bradfordembedded/i2cu/i2cu.sch

## KiCad design i2cu.sch (2015-09-01)

Schematic: i2cu.sch

Parts:
C1: 4.7N
C2, C3, C9, C11, C12, C13: 1U
C4, C5, C6, C7, C8, C14, C15, C16, C17: 0.1U
C10: 0.01U
D1, D5, D6: DRTR5VOU2SR
D2, D3, D4: LED-GRN
FB1, FB2: MI0603L301R
FID1, FID3: FID-CIR
FID2: FID-SQUARE
HOLE1, HOLE2, HOLE3, HOLE4: HOLE-3.5MM
J1: USB-MICRO-B
J2: HEADER-6PIN-2ROW
R1: 1M
R2, R6, R10: 220
R3, R9: 825K
R4, R8: 220K
R5, R7, R11, R12, R13: 15K
TP1, TP2, TP3, TP4, TP5, TP6, TP7, TP8: TEST-PAD
U1: MCP6001
U2: MCP2221-QFN
U3: IFX21401MB
U4: FET-N
U5: FXMA2102L8X
U6: 74LVC1T45

Notes on the sheet:
DAC AND ADC TO USE 4.096 V REFERENCE INTERNALLY GENERATED
GAIN OF 1.266 4.096 V -> 5.188 V
ADC1_IN WILL BE 79% OF VOUT 5.191 V => 4.096 V
NOTE 1: ALL LEDS ARE GREEN 0603 WITH 35 mcd @ 20 mA 2.0 V DROP @ 20 mA
RUN SHLD AROUND EXTERIOR OF PCB FOR ESD PROTECTION
GPIO IS AN INPUT
