bradfordembedded/i2cu/(threads)

Thread 1 (2015-08-14):

Add output over-current protection

bradfa, 2015-08-14:
Cause we don't want to have a short fry the borad.  If the IFX LDO doesn't already do this by itself, add some discrete protection to hiccup.
Ideally the over current protection would just hiccup (fold back, then turn back on, fold back, turn back on, etc) so that you don't have to unplug/replug the device when you cause a short.

A sensible limit of 100 mA output would likely be fine.

bradfa, 2015-08-18:
IFX21401 has an output current limit typical of 85 mA (51-120 mA min-max).  So this should take care of things.

Closed 2015-08-18.

Thread 2 (2015-08-14):

Tie shield and ground together with cap/resistor combo

bradfa, 2015-08-14:
To ensure ESD gets routed up to the host and absorbed correctly, as recommended by pretty much everyone.

Closed 2015-08-18.
