bradfordembedded/i2cu/(commit log)

2015-08-10 Schematic: Capture USB connector to USB2221 nets
    Includes +5V power and TVS for additional protection.
    [i2cu.sch]
2015-08-10 Schematic: Add fiducials and mounting holes
    [i2cu.sch]
2015-08-10 Schematic: Update info block
    [i2cu.sch]
2015-08-10 Schematic: Capture I2C level shifter our side
    [i2cu.sch]
2015-08-11 Schematic: Switch out MCP2221 for QFN version
    It'll be smaller in the final layout. Uses a different pinout than the
    DIP/TSSOP/SOIC version, so pins moved slightly to fit some NCs.
    [i2cu.sch]
2015-08-11 Schematic: Move level shifter rightwards
    To make more space for GPX and UXx pins to break outwards without
    needing to use net names.
    [i2cu.sch]
2015-08-11 Schematic: Move all captured circuits down and left
    For easier to fit the LED, ADC, DAC, and header without using net names.
    [i2cu.sch]
2015-08-11 Schematic: Capture output 6 pin header
    [i2cu.sch]
2015-08-11 Schematic: Fixup level shifter output side
    Add decoupling cap and neaten.
    [i2cu.sch]
2015-08-11 Schematic: Add decoupling and ESD protection to output header
    [i2cu.sch]
2015-08-11 Schematic: Capture variable output voltage source
    [i2cu.sch]
2015-08-13 Schematic: Use net names for USB2221 GP0-3
    [i2cu.sch]
2015-08-13 Schematic: Capture voltage divider for ADC1_IN
    Required moving the op-amp and LDO to the left to make space.
    [i2cu.sch]
2015-08-13 Schematic: Add decoupling cap to USB2221 VDD pin
    [i2cu.sch]
2015-08-13 Schematic: Change caps on USB2221 VUSB to 0.3 uF total
    Data sheet says 0.22 to 0.47 uF is recommended. Since 0.1 uF caps are
    cheap (no placement fees at macrofab), just use 3 of them.
    [i2cu.sch]
2015-08-13 Schematic: Capture I2C_LED
    147 ohms with 2.0 V drop when supplied with 5.0 V will result in 20.4 mA
    and approximately 35 mcd light output.
    [i2cu.sch]
2015-08-14 Schematic: Switch LED current limit R to 220 ohm
    Single resistor
    [i2cu.sch]
2015-08-14 Schematic: Add green LEDs for power in & out
    [i2cu.sch]
2015-08-14 Schematic: Remove DAC_OUT net name, use wire
    Because I can!
    [i2cu.sch]
2015-08-14 Schematic: Use GPIO for OE of level shifter
    So we can shut ourselves off from the target, if desired.
    Factory default state for GP0 GPIO is output, high, but pull up to
    ensure if it's tristated that it turns on by default.
    [i2cu.sch]
2015-08-14 Schematic: Put DAC1_OUT label back in, more clear
    [i2cu.sch]
2015-08-14 Schematic: Mark UART lines as NC
    [i2cu.sch]
2015-08-18 Schematic: Tie SHLD and GND thru parallel R and C
    Closes #2
    [i2cu.sch]
2015-08-18 Schematic: Tie I2C level shifter OE high
    No control for th level shifter, it's always on.
    Want to use the GPIO as an input.
    [i2cu.sch]
2015-08-18 Schematic: Change GPIO to input from target
    With level shifter and ESD protection.
    [i2cu.sch]
2015-08-18 Schematic: Double-up 1U caps
    There's 3 places where 1U caps are used:
    1. USB VCC input
    2. Input to LDO
    3. Output from LDO
    Double-up for 2U worth of cap on each location to help reduce noise and
    issues with sourcing large current changes. IFX LDO also recommends
    minimum 1U on the output.
    [i2cu.sch]
2015-08-18 Schematic: Mark unused ESD diode pin as NC
    [i2cu.sch]
2015-08-18 Schematic: Annotate!
    [i2cu.sch]
2015-08-18 Schematic: Rev A release
    [i2cu.sch]
2015-09-01 Schematic: Set rev PRE-B, open/save in KiCad r6132
    Open and save in a much newer version of KiCad (bzr rev 6132) which
    adjusted the location of some nets downwards into the title block and
    moved notes (their location point seems to have changed).
    Set rev of the schematic to PRE-B.
    [i2cu.sch]
2015-09-01 Schematic: Add test pads on interesting nets
    For probing the prototype during bring-up to ensure proper operation due
    to small component sizes, since probing the component pins themselves
    may be very difficult.
    [i2cu.sch]
2015-09-01 Schematic: Re-annotate
    Some of the power nets have changed annotation even though annotation
    was run and set to preserve existing annotations...
    [i2cu.sch]
