bradfordembedded/i2cu/(notices)

Notices in the files:
i2cu.sch:
(C) 2015 Andrew Bradford
Licensed under the CERN OHL v1.2
